garrettsworkshop/TimeDisk/Documentation/TimeDisk.4206B-Schematic.pdf

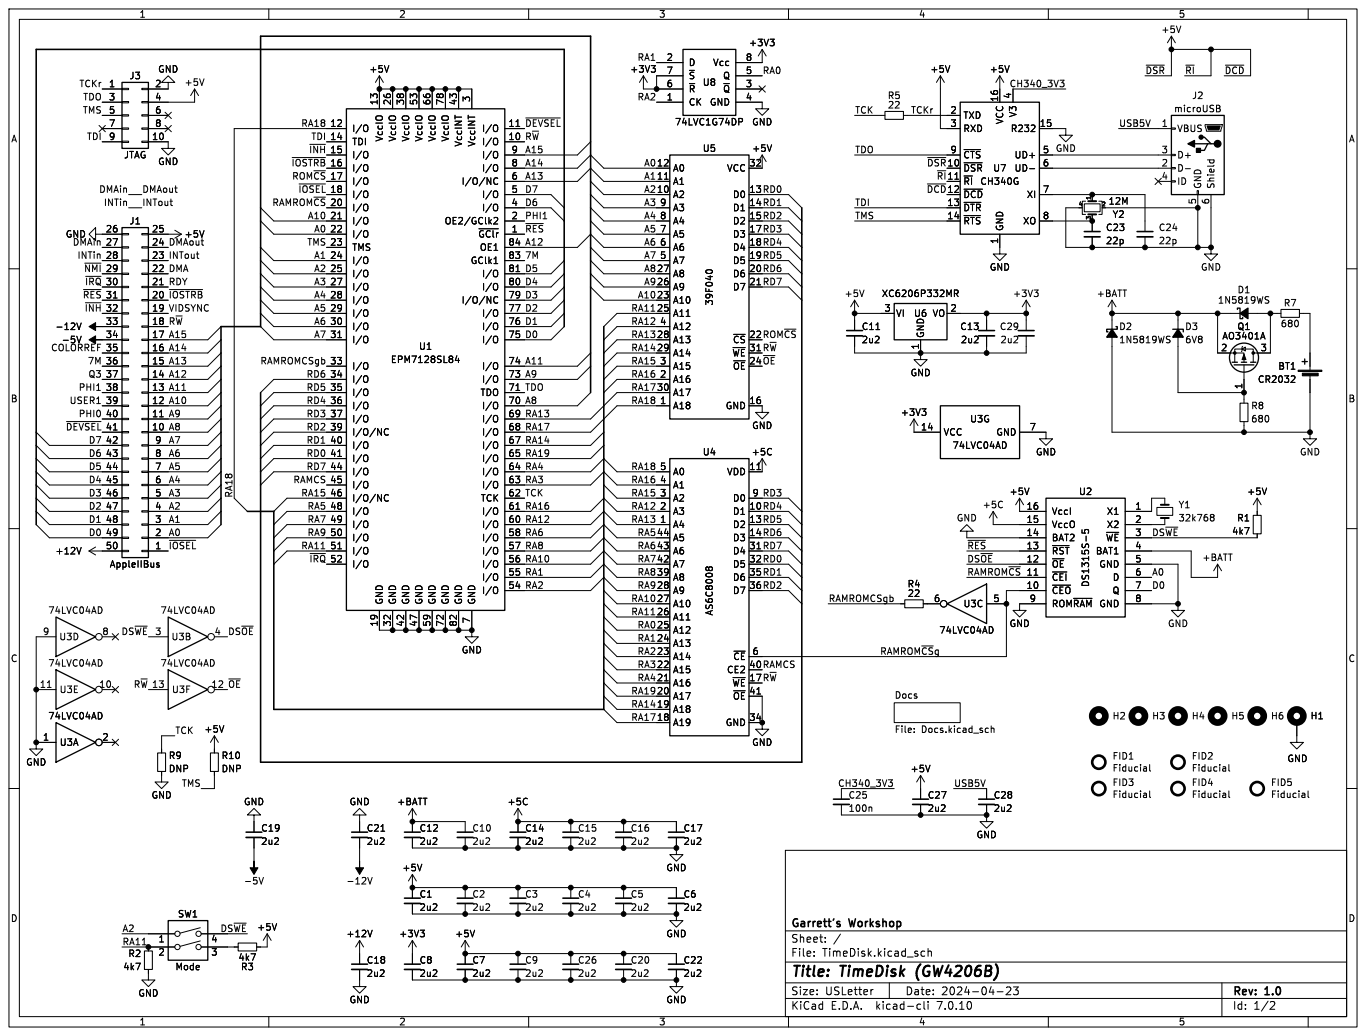
[picture p6: page 1]

4 UD+ 5 UD- 6 XI 7 XO 8 ~{CTS} 9 +5V C23

1 ~{DSR} 10 ~{RI} 11 ~{DCD} 12 ~{DTR} 13 ~{RTS} 14 R232 VCC 15 16 TXD 2 RXD 3 V3

4 UD+ 5 UD- 6 XI 7 XO 8 ~{CTS} 9 U7 CH340G

Id: 1/2 Title: TimeDisk (GW4206B) File: TimeDisk.kicad_sch Sheet: / Garrett's WorkshopDocs File: Docs.kicad_sch

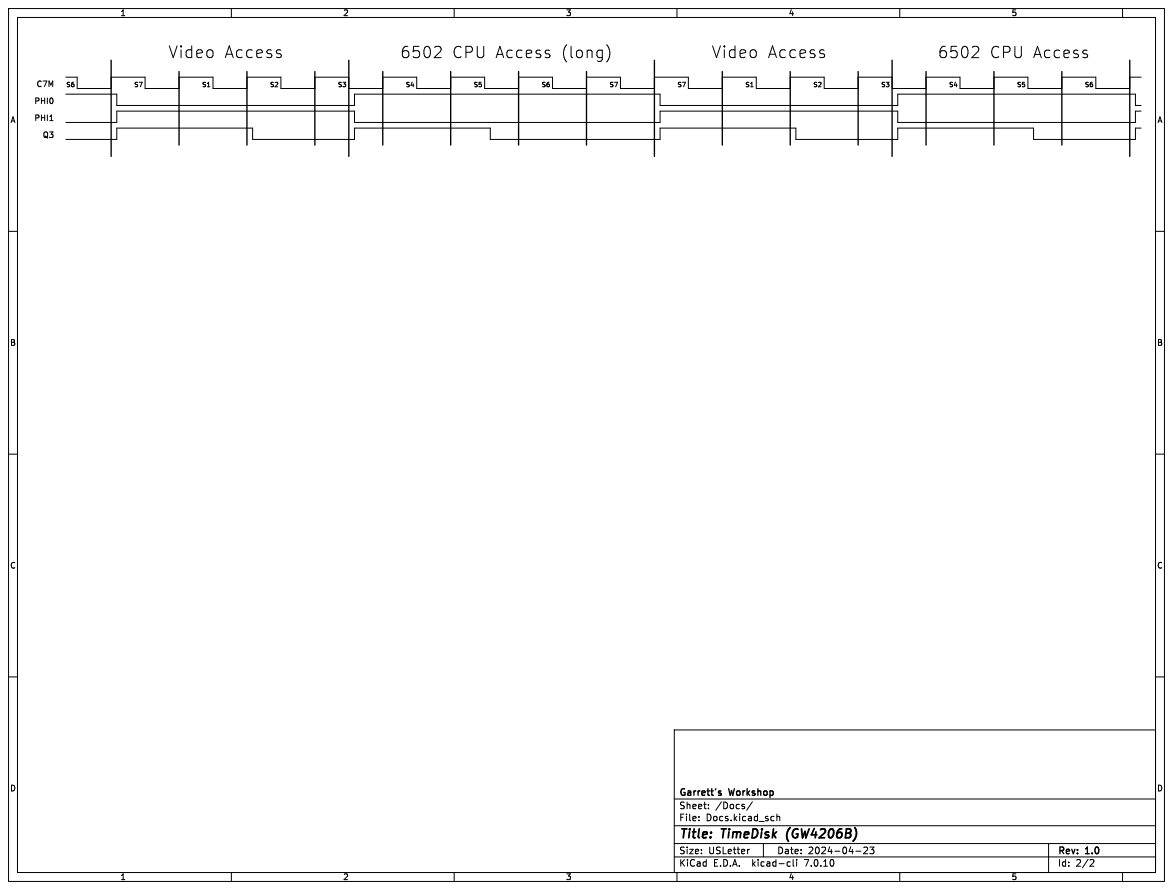
[picture p7: page 2]

Id: 2/2 Title: TimeDisk (GW4206B) File: Docs.kicad_sch Sheet: /Docs/ Garrett's Workshop
