garrettsworkshop/TimeDisk/Documentation/TimeDisk.4206B-Placement.pdf

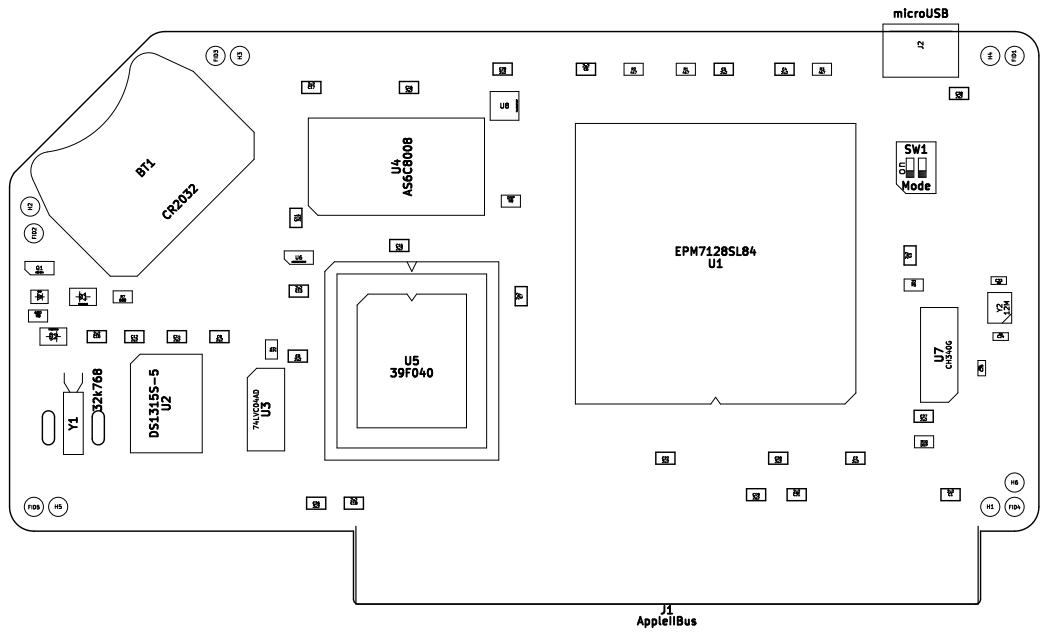
[picture p8: page 1]
