garrettsworkshop/TimeDisk/TimeDisk.kicad_pcb

## KiCad design TimeDisk.kicad_pcb (2024-04-24)

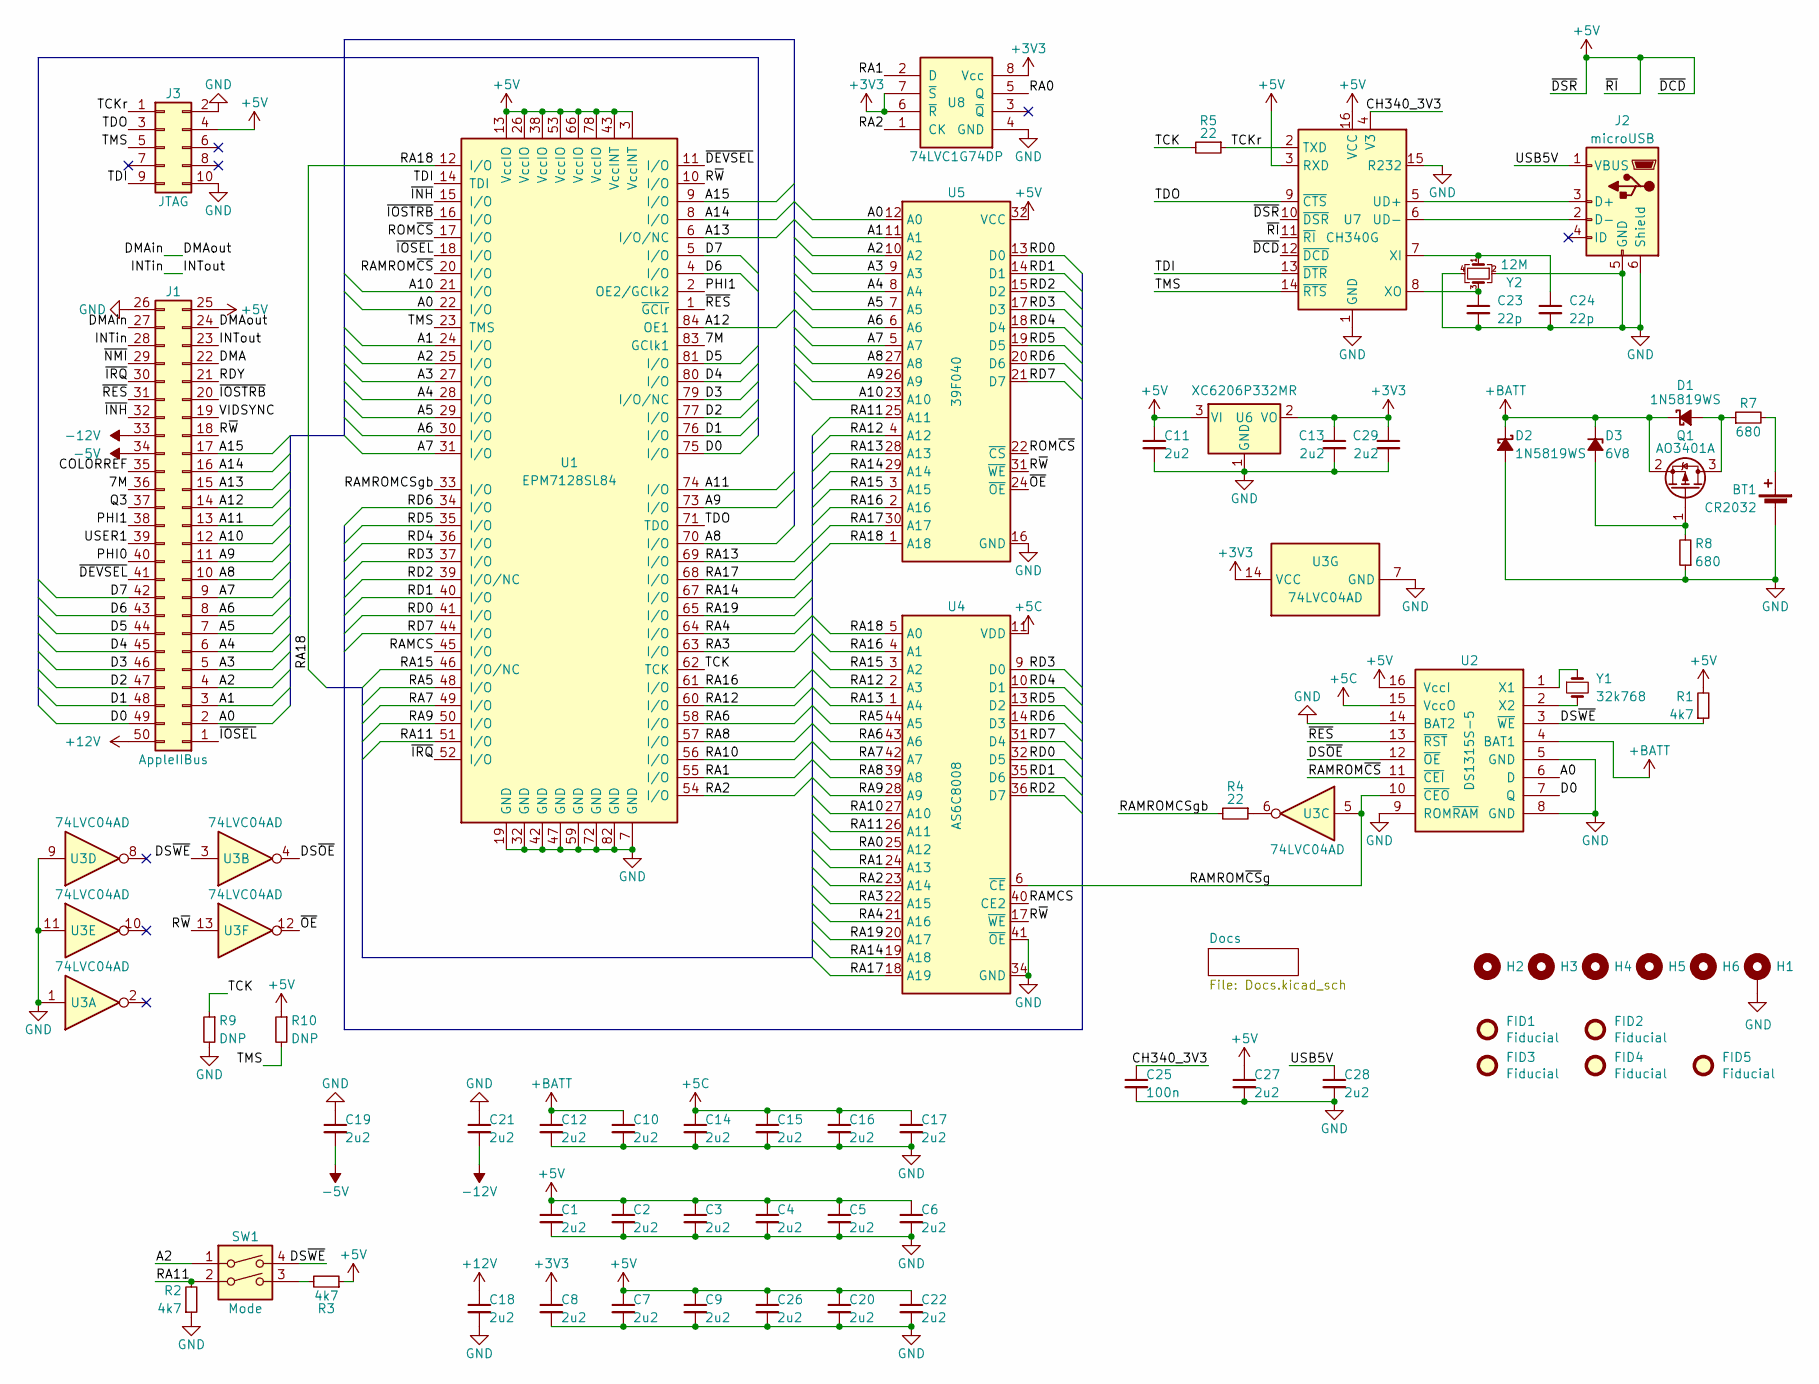
[picture p9: schematic TimeDisk.kicad_sch, TimeDisk (GW4206B)]

Parts:
BT1: CR2032; Keystone_3034_2032; LCSC Part C964833
C1, C2, C3, C4, C5, C6, C7, C8, C9, C10, C11, C12, C13, C14, C15, C16, C17, C18, C19, C20, C21, C22, C26, C27, C28, C29: 2u2; C_0805; LCSC Part C87994
C23, C24: 22p; C_0603; LCSC Part C1653
C25: 100n; C_0603; LCSC Part C28233
D1, D2: 1N5819WS; D_SOD-123; LCSC Part C191023
D3: 6V8; D_SOD-323; LCSC Part C118604
FID1, FID2, FID3, FID4, FID5: Fiducial
H1: PasteHole_1.1mm_PTH
H2, H3, H4, H5, H6: PasteHole_1.152mm_NPTH
J1: AppleIIBus; AppleIIBus_Edge
J2: microUSB; USB_Micro-B_Amphenol_10118192-0001; LCSC Part C132564
J3: JTAG; Header_2x5_Unshrouded_P1.27mm
Q1: AO3401A; SOT-23; LCSC Part C15127
R1, R2, R3: 4k7; R_0805; LCSC Part C17673
R4, R5: 22; R_0805; LCSC Part C17561
R7, R8: 680; R_0805; LCSC Part C17798
R9, R10: DNP; R_0805
SW1: Mode; SW_DIP_SPSTx02_Slide_DSHP02TS_P1.27mm
U1: EPM7128SL84; PLCC-84
U2: DS1315S-5; SOIC-16_7.5mm
U3: 74LVC04AD; SOIC-14_3.9mm; LCSC Part C190764
U4: AS6C8008; TSOP-II-44_400mil_P0.8mm; LCSC Part C1349342
U5: 39F040; PLCC-32_SMDSocket; LCSC Part C645936
U6: XC6206P332MR; SOT-23; LCSC Part C5446
U7: CH340G; SOIC-16_3.9mm; LCSC Part C14267
U8: 74LVC1G74DP; NXP_TSSOP-8_3x3mm_P0.65mm; LCSC Part C458768
Y1: 32k768; Crystal_C26-LF_D2.1mm_L6.5mm_Horizontal
Y2: 12M; Crystal_SMD_3225-4Pin_3.2x2.5mm; LCSC Part C9002

Connections:
+3V3: C8.1, C13.1, C29.1, U3.14 (VCC), U6.2 (VO), U8.6 (~R), U8.7 (~S), U8.8 (Vcc)
+5C: C14.1, C15.1, C16.1, C17.1, U2.15 (VccO), U4.11 (VDD), U4.33 (VDD)
+5V: C1.1, C2.1, C3.1, C4.1, C5.1, C6.1, C7.1, C9.1, C11.1, C20.1, C22.1, C26.1, C27.1, J1.25, J3.4, R1.2, R3.1, R10.1, U1.3 (VccINT), U1.13 (VccIO), U1.26 (VccIO), U1.38 (VccIO), U1.43 (VccINT), U1.53 (VccIO), U1.66 (VccIO), U1.78 (VccIO), U2.16 (VccI), U5.32 (VCC), U6.3 (VI), U7.3 (RXD), U7.10 (~DSR), U7.11 (~RI), U7.12 (~DCD), U7.16 (VCC)
+12V: C18.1, J1.50
+BATT: C10.1, C12.1, D1.1 (K), D2.1 (K), D3.1 (K), Q1.2 (S), U2.4 (BAT1)
-5V: C19.2, J1.34
-12V: C21.2, J1.33
/7M: J1.36, U1.83 (GClk1)
/A0: J1.2, U1.22 (I/O), U2.6 (D), U5.12 (A0)
/A1: J1.3, U1.24 (I/O), U5.11 (A1)
/A2: J1.4, SW1.1, U1.25 (I/O), U5.10 (A2)
/A3: J1.5, U1.27 (I/O), U5.9 (A3)
/A4: J1.6, U1.28 (I/O), U5.8 (A4)
/A5: J1.7, U1.29 (I/O), U5.7 (A5)
/A6: J1.8, U1.30 (I/O), U5.6 (A6)
/A7: J1.9, U1.31 (I/O), U5.5 (A7)
/A8: J1.10, U1.70 (I/O), U5.27 (A8)
/A9: J1.11, U1.73 (I/O), U5.26 (A9)
/A10: J1.12, U1.21 (I/O), U5.23 (A10)
/A11: J1.13, U1.74 (I/O)
/A12: J1.14, U1.84 (OE1)
/A13: J1.15, U1.6 (I/O/NC)
/A14: J1.16, U1.8 (I/O)
/A15: J1.17, U1.9 (I/O)
/CH340_3V3: C25.1, U7.4 (V3)
/COLORREF: J1.35
/D0: J1.49, U1.75 (I/O), U2.7 (Q)
/D1: J1.48, U1.76 (I/O)
/D2: J1.47, U1.77 (I/O)
/D3: J1.46, U1.79 (I/O/NC)
/D4: J1.45, U1.80 (I/O)
/D5: J1.44, U1.81 (I/O)
/D6: J1.43, U1.4 (I/O)
/D7: J1.42, U1.5 (I/O)
/DMA: J1.22
/DMAin: J1.24, J1.27
/DS~OE: U2.12 (~OE), U3.4
/DS~WE: R1.1, SW1.4, U2.3 (~WE), U3.3
/INTin: J1.23, J1.28
/PHI0: J1.40
/PHI1: J1.38, U1.2 (OE2/GClk2)
/Q3: J1.37
/RA0: U4.25 (A12), U8.5 (Q)
/RA1: U1.55 (I/O), U4.24 (A13), U8.2 (D)
/RA2: U1.54 (I/O), U4.23 (A14), U8.1 (CK)
/RA3: U1.63 (I/O), U4.22 (A15)
/RA4: U1.64 (I/O), U4.21 (A16)
/RA5: U1.48 (I/O), U4.44 (A5)
/RA6: U1.58 (I/O), U4.43 (A6)
/RA7: U1.49 (I/O), U4.42 (A7)
/RA8: U1.57 (I/O), U4.39 (A8)
/RA9: U1.50 (I/O), U4.28 (A9)
/RA10: U1.56 (I/O), U4.27 (A10)
/RA11: R2.2, SW1.2, U1.51 (I/O), U4.26 (A11), U5.25 (A11)
/RA12: U1.60 (I/O), U4.2 (A3), U5.4 (A12)
/RA13: U1.69 (I/O), U4.1 (A4), U5.28 (A13)
/RA14: U1.67 (I/O), U4.19 (A18), U5.29 (A14)
/RA15: U1.46 (I/O/NC), U4.3 (A2), U5.3 (A15)
/RA16: U1.61 (I/O), U4.4 (A1), U5.2 (A16)
/RA17: U1.68 (I/O), U4.18 (A19), U5.30 (A17)
/RA18: U1.12 (I/O), U4.5 (A0), U5.1 (A18)
/RA19: U1.65 (I/O), U4.20 (A17)
/RAMCS: U1.45 (I/O), U4.40 (CE2)
/RAMROMCSgb: R4.2, U1.33 (I/O)
/RAMROM~CS: U1.20 (I/O), U2.11 (~CEI)
/RAMROM~CSg: U2.10 (~CEO), U3.5, U4.6 (~CE)
/RD0: U1.41 (I/O), U4.32 (D5), U5.13 (D0)
/RD1: U1.40 (I/O), U4.35 (D6), U5.14 (D1)
/RD2: U1.39 (I/O/NC), U4.36 (D7), U5.15 (D2)
/RD3: U1.37 (I/O), U4.9 (D0), U5.17 (D3)
/RD4: U1.36 (I/O), U4.10 (D1), U5.18 (D4)
/RD5: U1.35 (I/O), U4.13 (D2), U5.19 (D5)
/RD6: U1.34 (I/O), U4.14 (D3), U5.20 (D6)
/RD7: U1.44 (I/O), U4.31 (D4), U5.21 (D7)
/RDY: J1.21
/ROM~CS: U1.17 (I/O), U5.22 (~CS)
/R~W: J1.18, U1.10 (I/O), U3.13, U4.17 (~WE), U5.31 (~WE)
/TCK: R5.2, R9.1, U1.62 (TCK)
/TCKr: J3.1, R5.1, U7.2 (TXD)
/TDI: J3.9, U1.14 (TDI), U7.13 (~DTR)
/TDO: J3.3, U1.71 (TDO), U7.9 (~CTS)
/TMS: J3.5, R10.2, U1.23 (TMS), U7.14 (~RTS)
/USB5V: C28.1, J2.1 (VBUS)
/USER1: J1.39
/VIDSYNC: J1.19
/~DEVSEL: J1.41, U1.11 (I/O)
/~INH: J1.32, U1.15 (I/O)
/~IOSEL: J1.1, U1.18 (I/O)
/~IOSTRB: J1.20, U1.16 (I/O)
/~IRQ: J1.30, U1.52 (I/O)
/~NMI: J1.29
/~OE: U3.12, U5.24 (~OE)
/~RES: J1.31, U1.1 (~GClr), U2.13 (~RST)
GND: BT1.2 (-), C1.2, C2.2, C3.2, C4.2, C5.2, C6.2, C7.2, C8.2, C9.2, C10.2, C11.2, C12.2, C13.2, C14.2, C15.2, C16.2, C17.2, C18.2, C19.1, C20.2, C21.1, C22.2, C23.2, C24.2, C25.2, C26.2, C27.2, C28.2, C29.2, D2.2 (A), H1.1, J1.26, J2.5 (GND), J2.6 (Shield), J3.2, J3.10, R2.1, R8.1, R9.2, U1.7 (GND), U1.19 (GND), U1.32 (GND), U1.42 (GND), U1.47 (GND), U1.59 (GND), U1.72 (GND), U1.82 (GND), U2.5 (GND), U2.8 (GND), U2.9 (ROM~RAM), U2.14 (BAT2), U3.1, U3.7 (GND), U3.9, U3.11, U4.12 (GND), U4.34 (GND), U4.41 (~OE), U5.16 (GND), U6.1 (GND), U7.1 (GND), U7.15 (R232), U8.4 (GND), Y2.2, Y2.4
unnamed: BT1.1 (+), R7.2
unnamed: D1.2 (A), Q1.3 (D), R7.1
unnamed: D3.2 (A), Q1.1 (G), R8.2
unnamed: J2.3 (D+), U7.5 (UD+)
unnamed: J2.2 (D-), U7.6 (UD-)
unnamed: R3.2, SW1.3
unnamed: R4.1, U3.6
unnamed: U2.1 (X1), Y1.1
unnamed: U2.2 (X2), Y1.2
unnamed: C24.1, U7.7 (XI), Y2.1
unnamed: C23.1, U7.8 (XO), Y2.3

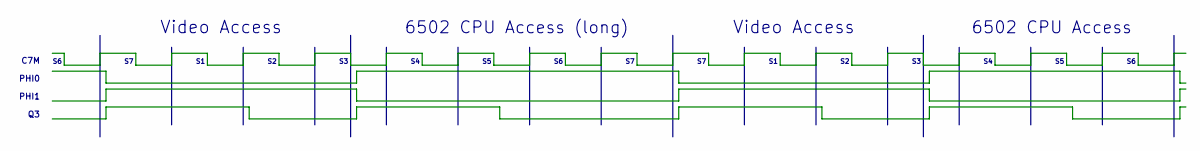
[picture p10: schematic Docs.kicad_sch, TimeDisk (GW4206B)]

Notes on the sheet:
PHI0
6502 CPU Access (long)
Video Access
6502 CPU Access
PHI1
C7M

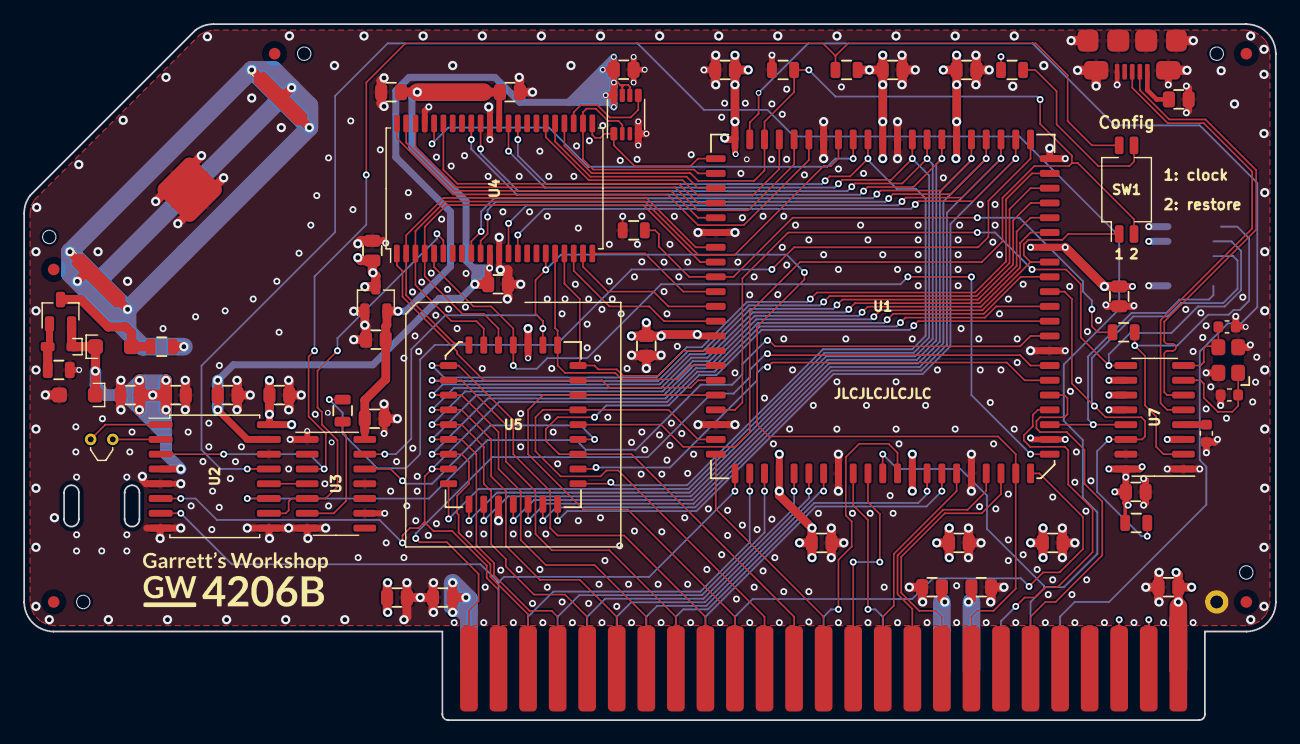
[picture p11: board TimeDisk.kicad_pcb from above]

Board: 4 copper layers, 107.6 x 59.8 mm, 68 parts (1 on the bottom side), 97 nets.
