garrettsworkshop/TimeDisk/(commit log)

2019-07-24 Done but I should probably buffer the data bus
    [TimeMachine.kicad_pcb]
2019-07-26 Buffered data bus with CPLD
    [Docs.sch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]
2019-07-30 Changed ROM OE strategy
    Has gerbers submitted to JLCPCB though
    [TimeMachine-B_Cu.gbl, TimeMachine-B_Mask.gbs, TimeMachine-B_SilkS.gbo, TimeMachine-Edge_Cuts.gm1, TimeMachine-F_Cu.gtl, TimeMachine-F_Mask.gts, TimeMachine-F_Paste.gtp, TimeMachine-F_SilkS.gto]
2019-07-30 Finished layout with new OE stuff.
    Updated gerbers and zip
    [TimeMachine-B_Cu.gbl, TimeMachine-B_Mask.gbs, TimeMachine-B_SilkS.gbo, TimeMachine-Edge_Cuts.gm1, TimeMachine-F_Cu.gtl, TimeMachine-F_Mask.gts, TimeMachine-F_Paste.gtp, TimeMachine-F_SilkS.gto]
2019-07-30 Submitted to JLCPCB
    [TimeMachine-B_Cu.gbl, TimeMachine-B_Mask.gbs, TimeMachine-B_SilkS.gbo, TimeMachine-Edge_Cuts.gm1, TimeMachine-F_Cu.gtl, TimeMachine-F_Mask.gts, TimeMachine-F_Paste.gtp, TimeMachine-F_SilkS.gto]
2019-08-20 Can't fit...
    [Docs.sch, TimeMachine.kicad_pcb, TimeMachine.sch]
2019-08-25 Lots of state machine work
    [Docs.sch, TimeMachine.kicad_pcb]
2019-09-05 Merged changes from GR8RAM, e.g. pipelined add
    [TimeMachine-B_Cu.gbl, TimeMachine-B_Mask.gbs, TimeMachine-B_SilkS.gbo, TimeMachine-Edge_Cuts.gm1, TimeMachine-F_Cu.gtl, TimeMachine-F_Mask.gts, TimeMachine-F_Paste.gtp, TimeMachine-F_SilkS.gto]
2019-09-06 Trying this on reworked boards
    [TimeMachine.sch]
2019-10-01 Fixed mistake, submitted to JLCPCB
    [TimeMachine-B_Cu.gbl, TimeMachine-B_Mask.gbs, TimeMachine-B_SilkS.gbo, TimeMachine-Edge_Cuts.gm1, TimeMachine-F_Cu.gtl, TimeMachine-F_Mask.gts, TimeMachine-F_Paste.gtp, TimeMachine-F_SilkS.gto]
2019-10-11 Switched schematic to new GW libraries
    [TimeMachine.sch]
2019-10-12 1 MB verilog for fixed board
2019-10-13 Changed libraries
    [Docs.sch, TimeMachine.kicad_pcb, TimeMachine.sch]
2019-10-14 TimeMachine prototype CPLD design works on IIgs
2019-10-18 New PLD revision
    For write operations, register data is latched in the middle of S6, 70ns before the end of PHI0. This gives more write data setup time, which may be needed on the Apple II with the 1 MHz 6502.
    [Docs.sch]
2020-02-09 Removed AVR-JTAG-10 connector footprint
    [TimeMachine.kicad_pcb]
2020-03-10 many PLD changes to do new pseudo-DMA stuff
2021-04-12 Revert "many PLD changes to do new pseudo-DMA stuff"
    This reverts commit 37f770932066a3aa4669307f4ca01c1315b127dd.
2021-04-12 Regenerated gerbers
    [TimeMachine-B_Cu.gbl, TimeMachine-B_Mask.gbs, TimeMachine-B_SilkS.gbo, TimeMachine-Edge_Cuts.gm1, TimeMachine-F_Cu.gtl, TimeMachine-F_Mask.gts, TimeMachine-F_Paste.gtp, TimeMachine-F_SilkS.gto]
2021-04-12 Updated driver ROMs
2023-06-07 Add timer
    [TimeDisk.kicad_sch, TimeDisk.smp_dump.txt]
2024-01-27 idk if it's even good
    [TimeDisk.kicad_pcb, TimeDisk.kicad_sch]
2024-02-16 As sent to JLC
    [TimeDisk-B_Cu.gbl, TimeDisk-B_Mask.gbs, TimeDisk-B_Silkscreen.gbo, TimeDisk-Edge_Cuts.gm1, TimeDisk-F_Cu.gtl, TimeDisk-F_Mask.gts, TimeDisk-F_Paste.gtp, TimeDisk-F_Silkscreen.gto]
2024-03-11 Add RPP
    [TimeDisk-B_Cu.gbl, TimeDisk-B_Mask.gbs, TimeDisk-B_Silkscreen.gbo, TimeDisk-Edge_Cuts.gm1, TimeDisk-F_Cu.gtl, TimeDisk-F_Mask.gts, TimeDisk-F_Paste.gtp, TimeDisk-F_Silkscreen.gto]
2024-03-18 Update via-to-via clearance rules and update footprints
    [TimeDisk.kicad_pcb, TimeDisk.kicad_sch]
2024-03-22 with hole
    [Docs.kicad_sch, TimeDisk.kicad_pcb, TimeDisk.kicad_sch]
2024-03-29 RC 1.1
    [TimeDisk-B_Cu.gbl, TimeDisk-B_Mask.gbs, TimeDisk-B_Silkscreen.gbo, TimeDisk-Edge_Cuts.gm1, TimeDisk-F_Cu.gtl, TimeDisk-F_Mask.gts, TimeDisk-F_Paste.gtp, TimeDisk-F_Silkscreen.gto]
2024-03-29 Go back to calling this version 1.0... RC 1.0
    [TimeDisk-B_Cu.gbl, TimeDisk-B_Mask.gbs, TimeDisk-B_Silkscreen.gbo, TimeDisk-Edge_Cuts.gm1, TimeDisk-F_Cu.gtl, TimeDisk-F_Mask.gts, TimeDisk-F_Paste.gtp, TimeDisk-F_Silkscreen.gto]
2024-05-14 B.1.0 RC2/3
    [TimeDisk.kicad_sch]
